Spring-Ltc/High-power-signal-source-based-on-SPWM/NEW.bmp

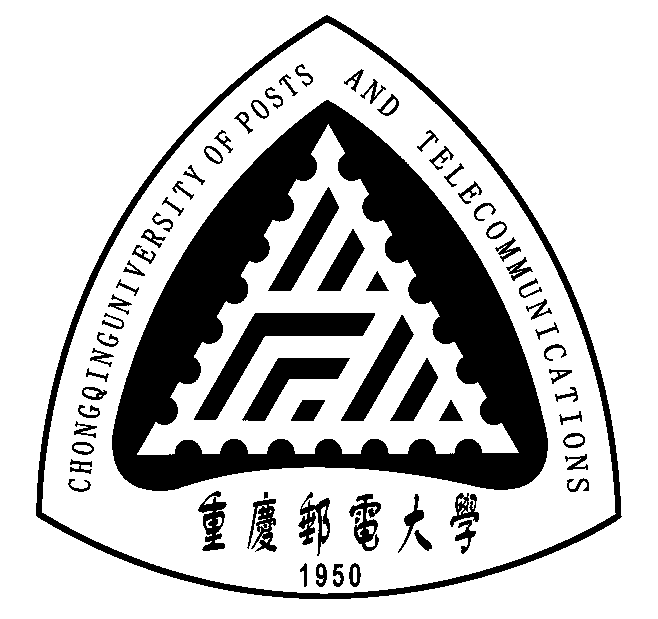
NEW.bmp
