Spring-Ltc/High-power-signal-source-based-on-SPWM/器件采购列表.xlsx

名称 | 参数 | 封装 | 单板数量 | 备注 | 参考购买链接
无源晶振 | 32.768kHz | 3215 | 1 |  | https://item.taobao.com/item.htm?spm=a1z10.3-c-s.w4002-21223910208.15.6c196a4bDiknMe&id=522572518591
无源晶振 | 8MHz | 5032 | 1 |  | https://item.taobao.com/item.htm?spm=a1z10.3-c-s.w4002-21223910208.10.6ebe6a4b9ByRfy&id=534951404430
无源晶振 | 12MHz | 49S | 1 |  | https://item.taobao.com/item.htm?spm=a1z10.3-c-s.w4002-21223910208.15.20486a4b0EgIEA&id=522574829676
