Spring-Ltc/High-power-signal-source-based-on-SPWM/ZhangXue_Project/ZhangXue.pdf

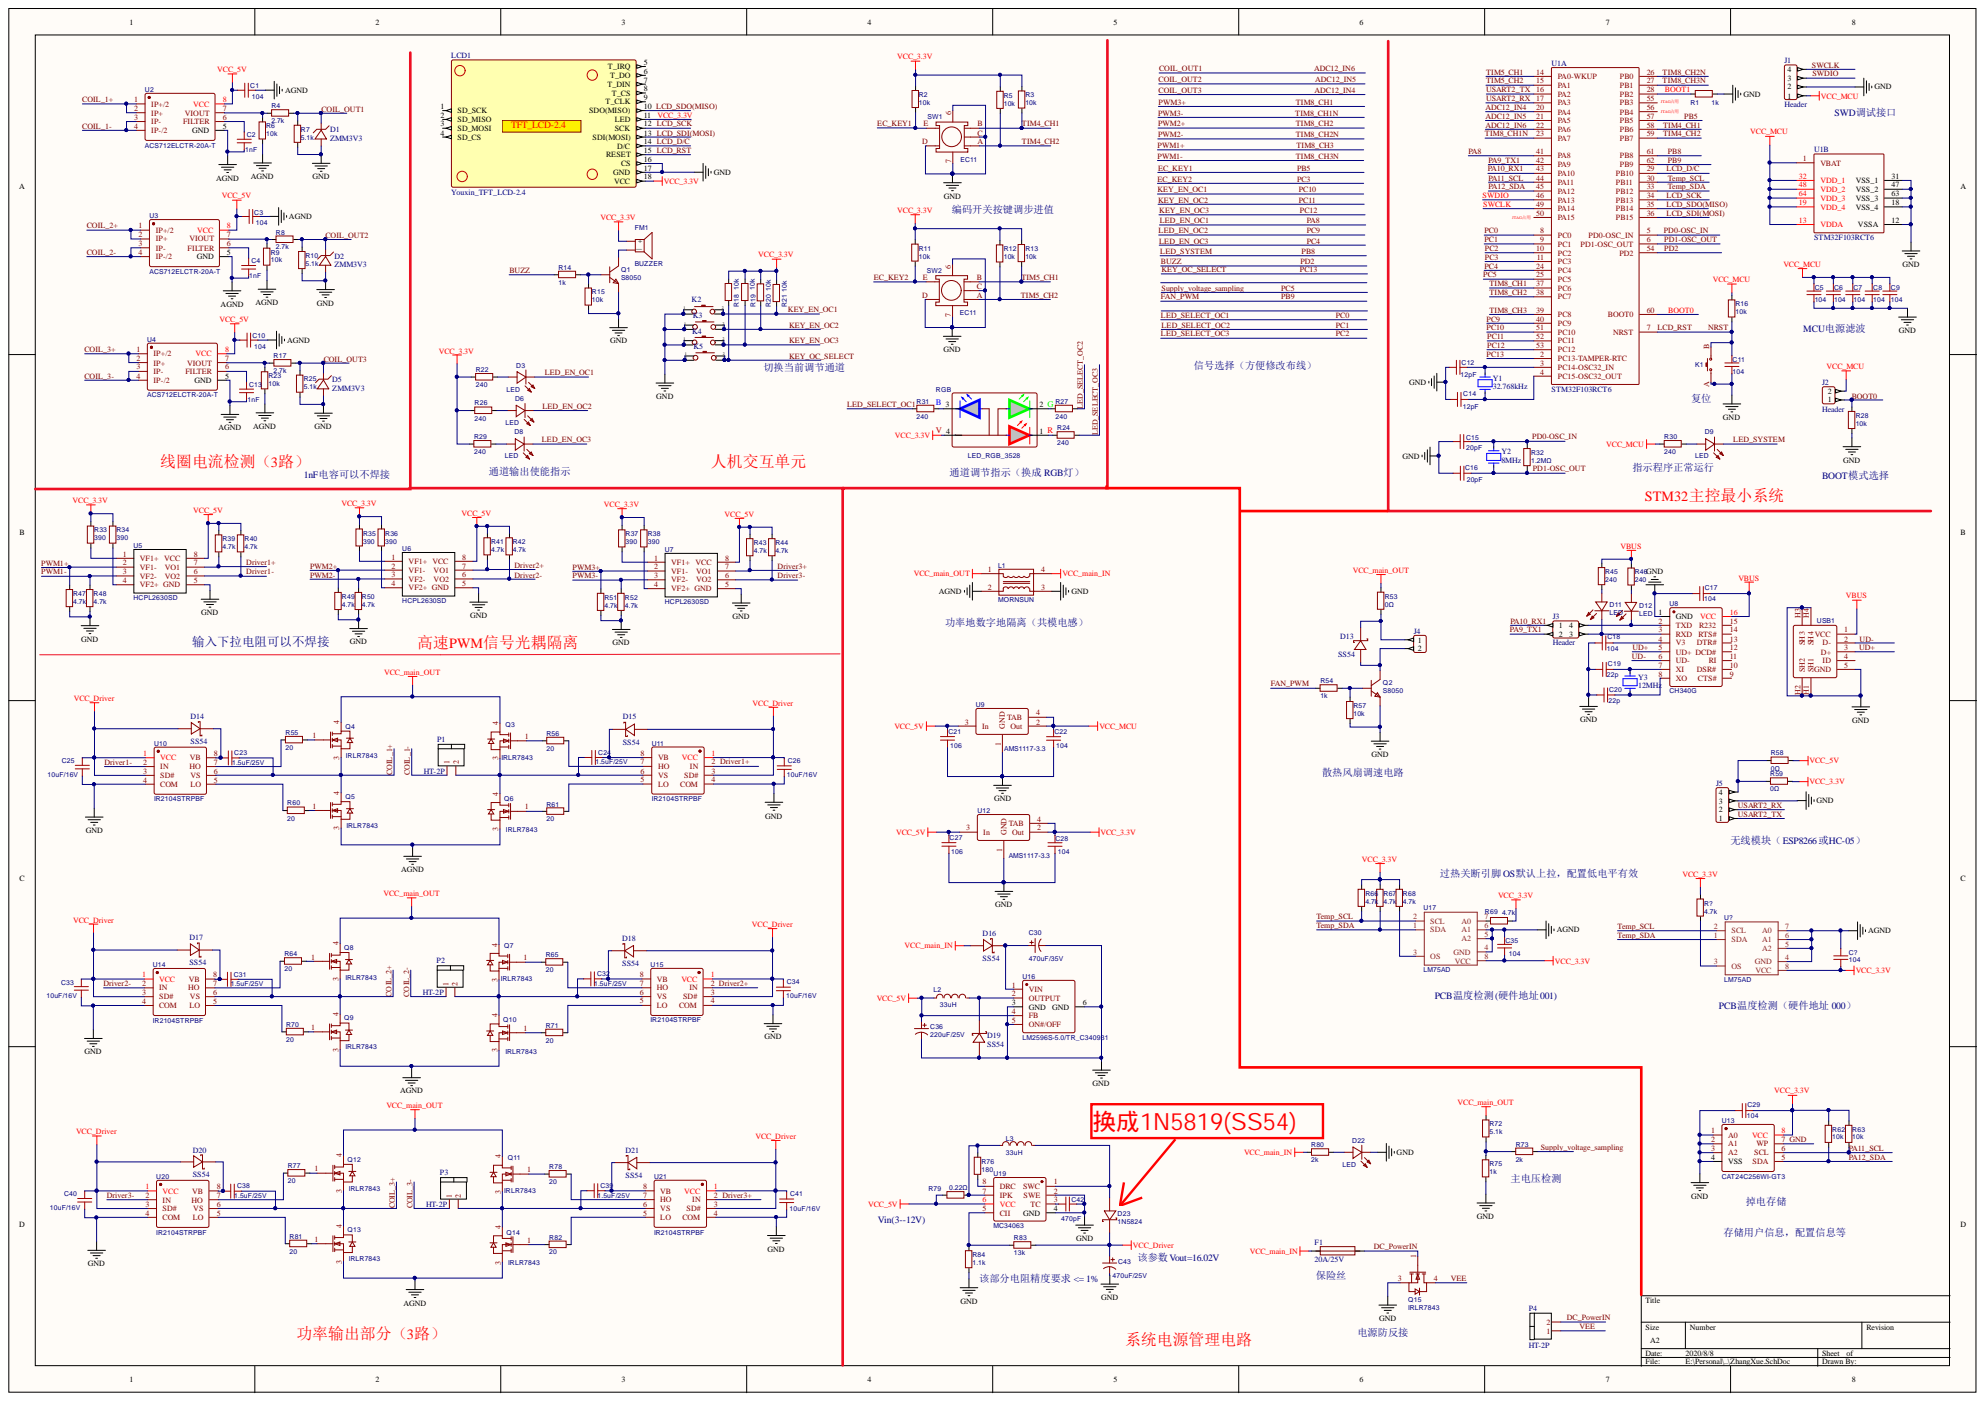
[picture p2: page 1]
