Spring-Ltc/High-power-signal-source-based-on-SPWM/ZhangXue_Project/ZhangXue_PCB.pdf

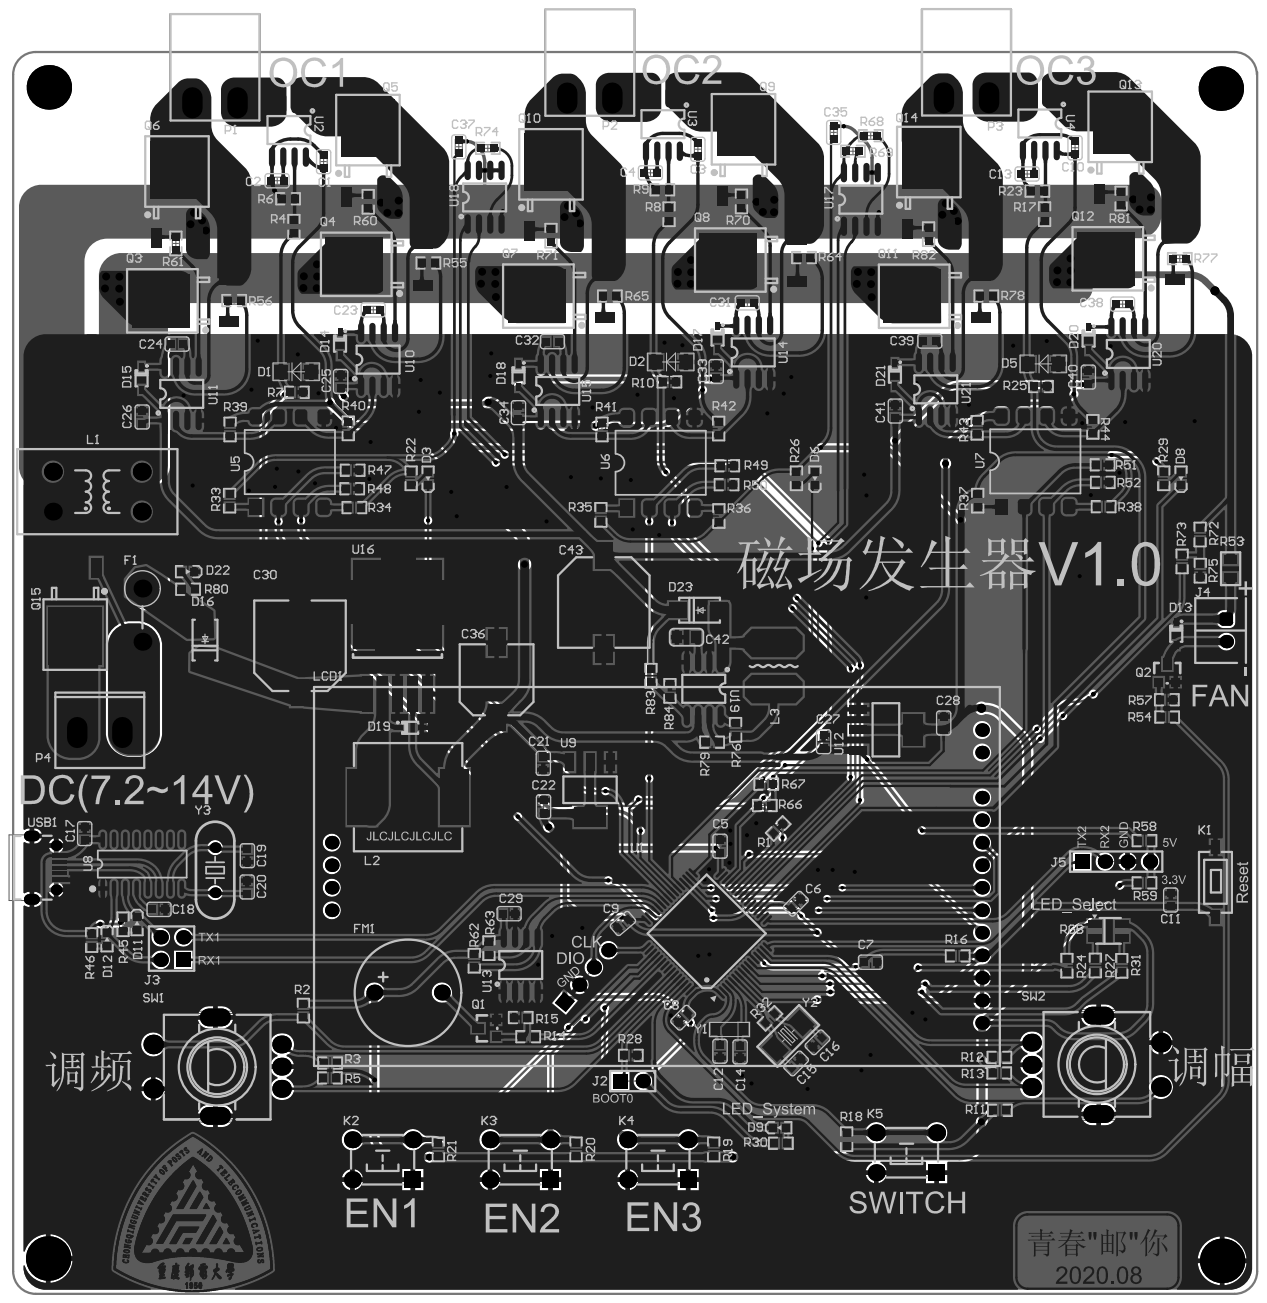
[picture p3: page 1]
