Spring-Ltc/High-power-signal-source-based-on-SPWM/(list of files, drawings)

Other design files:
Proteus_MCU/ProteusBasic20200814V1/ZhangXue.pdsprj
Proteus_MCU/ProteusBasic20200815V1/ZhangXue.pdsprj
Proteus_MCU/ProteusBasic/ZhangXue.pdsprj
ZhangXue_Project/LOGO1.PcbDoc
ZhangXue_Project/LOGO2.PcbDoc
ZhangXue_Project/LOGO_12.PcbDoc
ZhangXue_Project/ZhangXue.PcbDoc
ZhangXue_Project/ZhangXue.SchDoc
ZhangXue_Project/ZhangXue_Project1/ZhangXue.PcbLib
ZhangXue_Project/ZhangXue_Project1/ZhangXue_Project.SCHLIB
ZhangXue_Project/ZhangXue_Project.PrjPcb
