Spring-Ltc/High-power-signal-source-based-on-SPWM/ZhangXue_Keil5/Keil20200913V1(END)/HARDWARE/CurrentSensorADC.h

#ifndef __CurrentSensorADC_H__
#define __CurrentSensorADC_H__

#include "sys.h"


void CurrentADC_Init(void);
void SupplyVoltageADC_Init(void);
u16 ReadPowerVoltage(void);
u16  ReadCurrent(u8 OCelect);

#endif
