Spring-Ltc/High-power-signal-source-based-on-SPWM/ZhangXue_Keil5/Keil20200913V1(END)/HARDWARE/Encoder.h

#ifndef __Encoder_H__
#define __Encoder_H__

#include "sys.h"

//按键宏定义
#define KEY_Encod1				PBin(5)
#define KEY_Encod2				PCin(3)


#define EncodeMaxChange  30

void EC11Encoder_Init(void);








#endif
