Spring-Ltc/High-power-signal-source-based-on-SPWM/ZhangXue_Keil5/Keil20200913V1(END)/HARDWARE/Encoder.c

#include "Encoder.h"

//初始化旋转编码开关EC11的相关定时器及按键
//	Encode1：	A/PA0/TIM2_CH1
//						B/PA1/TIM2_CH2
//						KEY/PB5
//	Encode2:	A/PB6/TIM4_CH1
//						B/PB7/TIM4_CH2
//						KEY/PC3
void EC11Encoder_Init(void)
{
	GPIO_InitTypeDef 						GPIO_InitStruct;
	EXTI_InitTypeDef  					EXTI_InitStruct;
	NVIC_InitTypeDef  					NVIC_InitStruct;
	TIM_TimeBaseInitTypeDef 		TIM_TimeBaseInitStruct;
	
	RCC_APB2PeriphClockCmd(RCC_APB2Periph_GPIOA|RCC_APB2Periph_GPIOB|RCC_APB2Periph_GPIOC,ENABLE);//使能GPIO时钟
	RCC_APB1PeriphClockCmd(RCC_APB1Periph_TIM4|RCC_APB1Periph_TIM2,ENABLE);//定时器时钟使能
	RCC_APB2PeriphClockCmd(RCC_APB2Periph_AFIO,ENABLE);//开启复用时钟
	
	//GPIO初始化
	GPIO_InitStruct.GPIO_Mode=GPIO_Mode_IPU;//上拉输入
	GPIO_InitStruct.GPIO_Speed=GPIO_Speed_50MHz;
		//两个按键和定时器输入通道的GPIO口
		GPIO_InitStruct.GPIO_Pin=GPIO_Pin_0|GPIO_Pin_1;
		GPIO_Init(GPIOA,&GPIO_InitStruct);
		GPIO_InitStruct.GPIO_Pin=GPIO_Pin_5|GPIO_Pin_6|GPIO_Pin_7;
		GPIO_Init(GPIOB,&GPIO_InitStruct);
		GPIO_InitStruct.GPIO_Pin=GPIO_Pin_3;
		GPIO_Init(GPIOC,&GPIO_InitStruct);
	
	//=============编码器按键采用中断试一下呢====================//
	//中断线配置
	//GPIOB.5
	GPIO_EXTILineConfig(GPIO_PortSourceGPIOB,GPIO_PinSource5);
	EXTI_InitStruct.EXTI_Line = EXTI_Line5;
	EXTI_InitStruct.EXTI_LineCmd = ENABLE;
	EXTI_InitStruct.EXTI_Mode = EXTI_Mode_Interrupt;//中断模式
	EXTI_InitStruct .EXTI_Trigger = EXTI_Trigger_Falling;//下降沿触发
	EXTI_Init(&EXTI_InitStruct);
	//GPIOC.3
	GPIO_EXTILineConfig(GPIO_PortSourceGPIOC,GPIO_PinSource3);
	EXTI_InitStruct.EXTI_Line = EXTI_Line3;
	EXTI_Init(&EXTI_InitStruct);
	
	//中断优先级设置
	NVIC_InitStruct.NVIC_IRQChannel = EXTI9_5_IRQn;
	NVIC_InitStruct.NVIC_IRQChannelCmd = ENABLE;
	NVIC_InitStruct.NVIC_IRQChannelPreemptionPriority = 2;
	NVIC_InitStruct.NVIC_IRQChannelSubPriority =2;
	NVIC_Init(&NVIC_InitStruct);
	NVIC_InitStruct.NVIC_IRQChannel = EXTI3_IRQn;
	NVIC_InitStruct.NVIC_IRQChannelCmd = ENABLE;
	NVIC_InitStruct.NVIC_IRQChannelPreemptionPriority = 2;
	NVIC_InitStruct.NVIC_IRQChannelSubPriority =2;
	NVIC_Init(&NVIC_InitStruct);
	
	
	//=================================编码开关定时器相关设置===================//
	//定时器基本参数配置
	TIM_TimeBaseInitStruct.TIM_ClockDivision=TIM_CKD_DIV1;
	TIM_TimeBaseInitStruct.TIM_CounterMode=TIM_CounterMode_Up;//计数模式
	TIM_TimeBaseInitStruct.TIM_Period=0xffff;
	TIM_TimeBaseInitStruct.TIM_Prescaler=0x00;
	TIM_TimeBaseInitStruct.TIM_RepetitionCounter=0;//不用重复计数
		TIM_TimeBaseInit(TIM2,&TIM_TimeBaseInitStruct);
		TIM_TimeBaseInit(TIM4,&TIM_TimeBaseInitStruct);
	
	//配置编码器模式
	TIM_EncoderInterfaceConfig(TIM2,TIM_EncoderMode_TI1,TIM_ICPolarity_Falling,TIM_ICPolarity_Falling);
	TIM_EncoderInterfaceConfig(TIM4,TIM_EncoderMode_TI1,TIM_ICPolarity_Falling,TIM_ICPolarity_Falling);
	
	TIM_Cmd(TIM2,ENABLE);
	TIM_Cmd(TIM4,ENABLE);
}
