Spring-Ltc/High-power-signal-source-based-on-SPWM/(commit log)

2020-08-08 PCB和钢网文件发出，BOM表整理采购完成
    [ZhangXue.CSV]
2020-08-15 Proteus8.9软件仿真还不太成熟，用于STM32还有BUG，重新用Proteus8.6的工程
    [ZhangXue.pdsprj]
2020-09-07 把显示部分基本写得差不多了
    [STM32F103RCT6资源分配.xlsx]
2020-09-08 整体基本完成了，暂时只差温度检测和输出的SPWM了
2020-09-10 SPWM尝试30%
2020-09-11 SPWM进度99%
2020-09-12 LM75AD还有bug
2020-09-13 LM75AD温度检测OK
