Spring-Ltc/High-power-signal-source-based-on-SPWM/(notices)

Notices in the files:
ZhangXue_Keil5/Keil20200913V1(END)/USER/delay.c:
Copyright(C) ¹ãÖÝÊÐÐÇÒíµç×Ó¿Æ¼¼ÓÐÏÞ¹«Ë¾ 2009-2019
All rights reserved
